RSA-PPP/ppp-2026-13-geotech-multiplexor-24ch/docs/hardware/kicad/acople_esp32/acople_sp32.kicad_sch

## KiCad design docs/hardware/kicad/acople_esp32/acople_sp32.kicad_sch (2026-11-13)

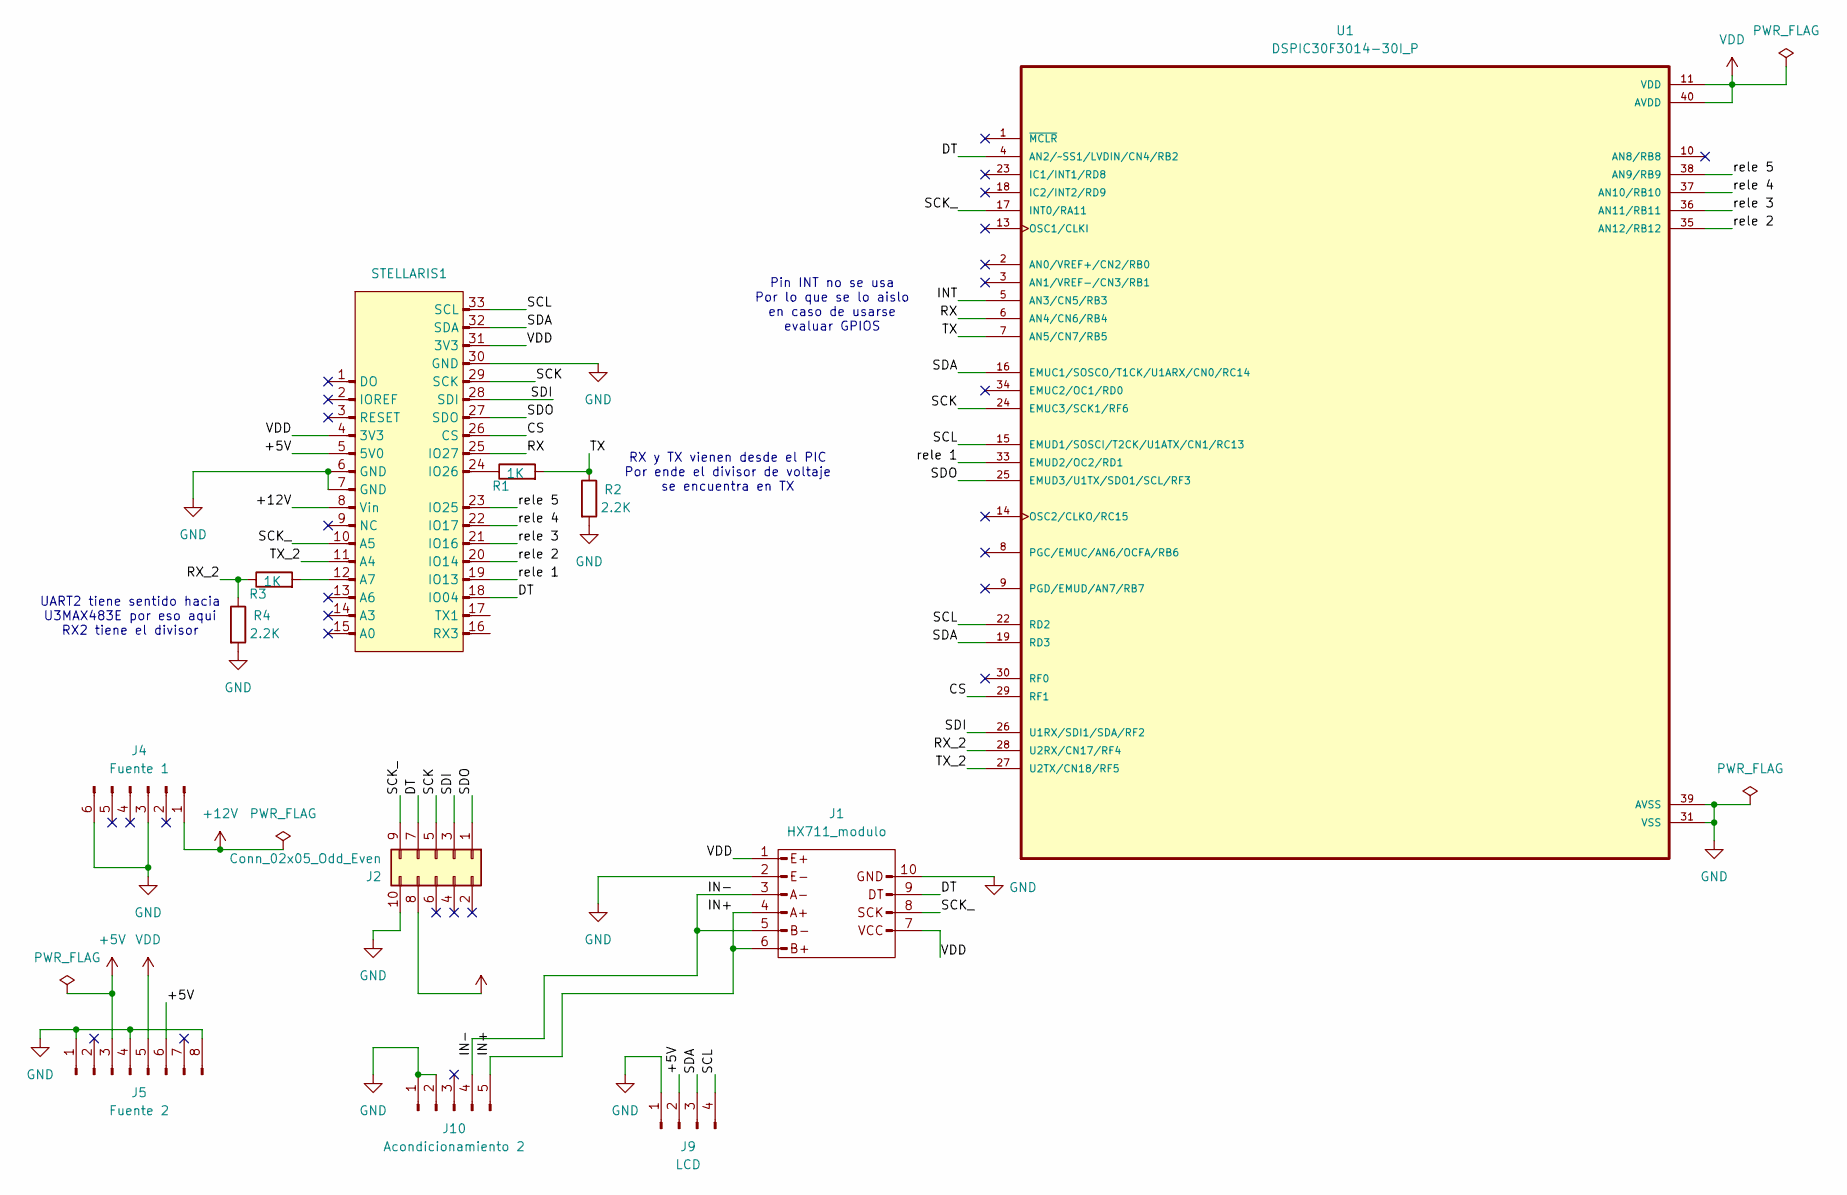
[picture p1: schematic acople_sp32.kicad_sch]

Parts:
J1: HX711_modulo; HX711
J2: Conn_02x05_Odd_Even; PinHeader_2x05_P2.54mm_Vertical
J4: Fuente 1; PinHeader_1x06_P2.54mm_Vertical
J5: Fuente 2; PinHeader_1x08_P2.54mm_Vertical
J9: LCD
J10: Acondicionamiento 2; PinHeader_1x05_P2.54mm_Vertical
R1, R3: 1K; DIP-8_W7.62mm
R2, R4: 2.2K
STELLARIS1: Stellaris_botton
U1: DSPIC30F3014-30I_P; QFP80P1200X1200X120-44N

Connections:
+5V: J5.3, J5.6, J9.2, STELLARIS1.5 (5V0)
+12V: J4.1, STELLARIS1.8 (Vin)
CS: STELLARIS1.26 (CS), U1.29 (RF1)
DT: J1.9, J2.7, STELLARIS1.18 (IO04), U1.4 (AN2/~SS1/LVDIN/CN4/RB2)
GND: J1.2, J1.10, J2.10, J4.3, J4.6, J5.1, J5.4, J5.8, J9.1, J10.1, J10.2, R2.2, R4.2, STELLARIS1.6 (GND), STELLARIS1.7 (GND), STELLARIS1.30 (GND), U1.12 (VSS), U1.20 (VSS), U1.31 (VSS), U1.39 (AVSS)
IN+: J1.4, J1.6, J10.5
IN-: J1.3, J1.5, J10.4
INT: U1.5 (AN3/CN5/RB3)
unnamed: R1.1, STELLARIS1.24 (IO26)
unnamed: R3.2, STELLARIS1.12 (A7)
RX: STELLARIS1.25 (IO27), U1.6 (AN4/CN6/RB4)
RX_2: R3.1, R4.1, U1.28 (U2RX/CN17/RF4)
SCK: J2.5, STELLARIS1.29 (SCK), U1.24 (EMUC3/SCK1/RF6)
SCK_: J1.8, J2.9, STELLARIS1.10 (A5), U1.17 (INT0/RA11)
SCL: J9.4, STELLARIS1.33 (SCL), U1.15 (EMUD1/SOSCI/T2CK/U1ATX/CN1/RC13), U1.22 (RD2)
SDA: J9.3, STELLARIS1.32 (SDA), U1.16 (EMUC1/SOSCO/T1CK/U1ARX/CN0/RC14), U1.19 (RD3)
SDI: J2.3, STELLARIS1.28 (SDI), U1.26 (U1RX/SDI1/SDA/RF2)
SDO: J2.1, STELLARIS1.27 (SDO), U1.25 (EMUD3/U1TX/SDO1/SCL/RF3)
TX: R1.2, R2.1, U1.7 (AN5/CN7/RB5)
TX_2: STELLARIS1.11 (A4), U1.27 (U2TX/CN18/RF5)
VDD: J1.1, J1.7, J2.8, J5.5, STELLARIS1.4 (3V3), STELLARIS1.31 (3V3), U1.11 (VDD), U1.21 (VDD), U1.32 (VDD), U1.40 (AVDD)
rele 1: STELLARIS1.19 (IO13), U1.33 (EMUD2/OC2/RD1)
rele 2: STELLARIS1.20 (IO14), U1.35 (AN12/RB12)
rele 3: STELLARIS1.21 (IO16), U1.36 (AN11/RB11)
rele 4: STELLARIS1.22 (IO17), U1.37 (AN10/RB10)
rele 5: STELLARIS1.23 (IO25), U1.38 (AN9/RB9)

Notes on the sheet:
RX y TX vienen desde el PIC Por ende el divisor de voltaje se encuentra en TX
UART2 tiene sentido hacia U3MAX483E por eso aqui RX2 tiene el divisor
Pin INT no se usa Por lo que se lo aislo en caso de usarse evaluar GPIOS
