RSA-PPP/ppp-2026-13-geotech-multiplexor-24ch/docs/hardware/kicad/puente_reles/puente.kicad_sch

## KiCad design docs/hardware/kicad/puente_reles/puente.kicad_sch (2026-11-13)

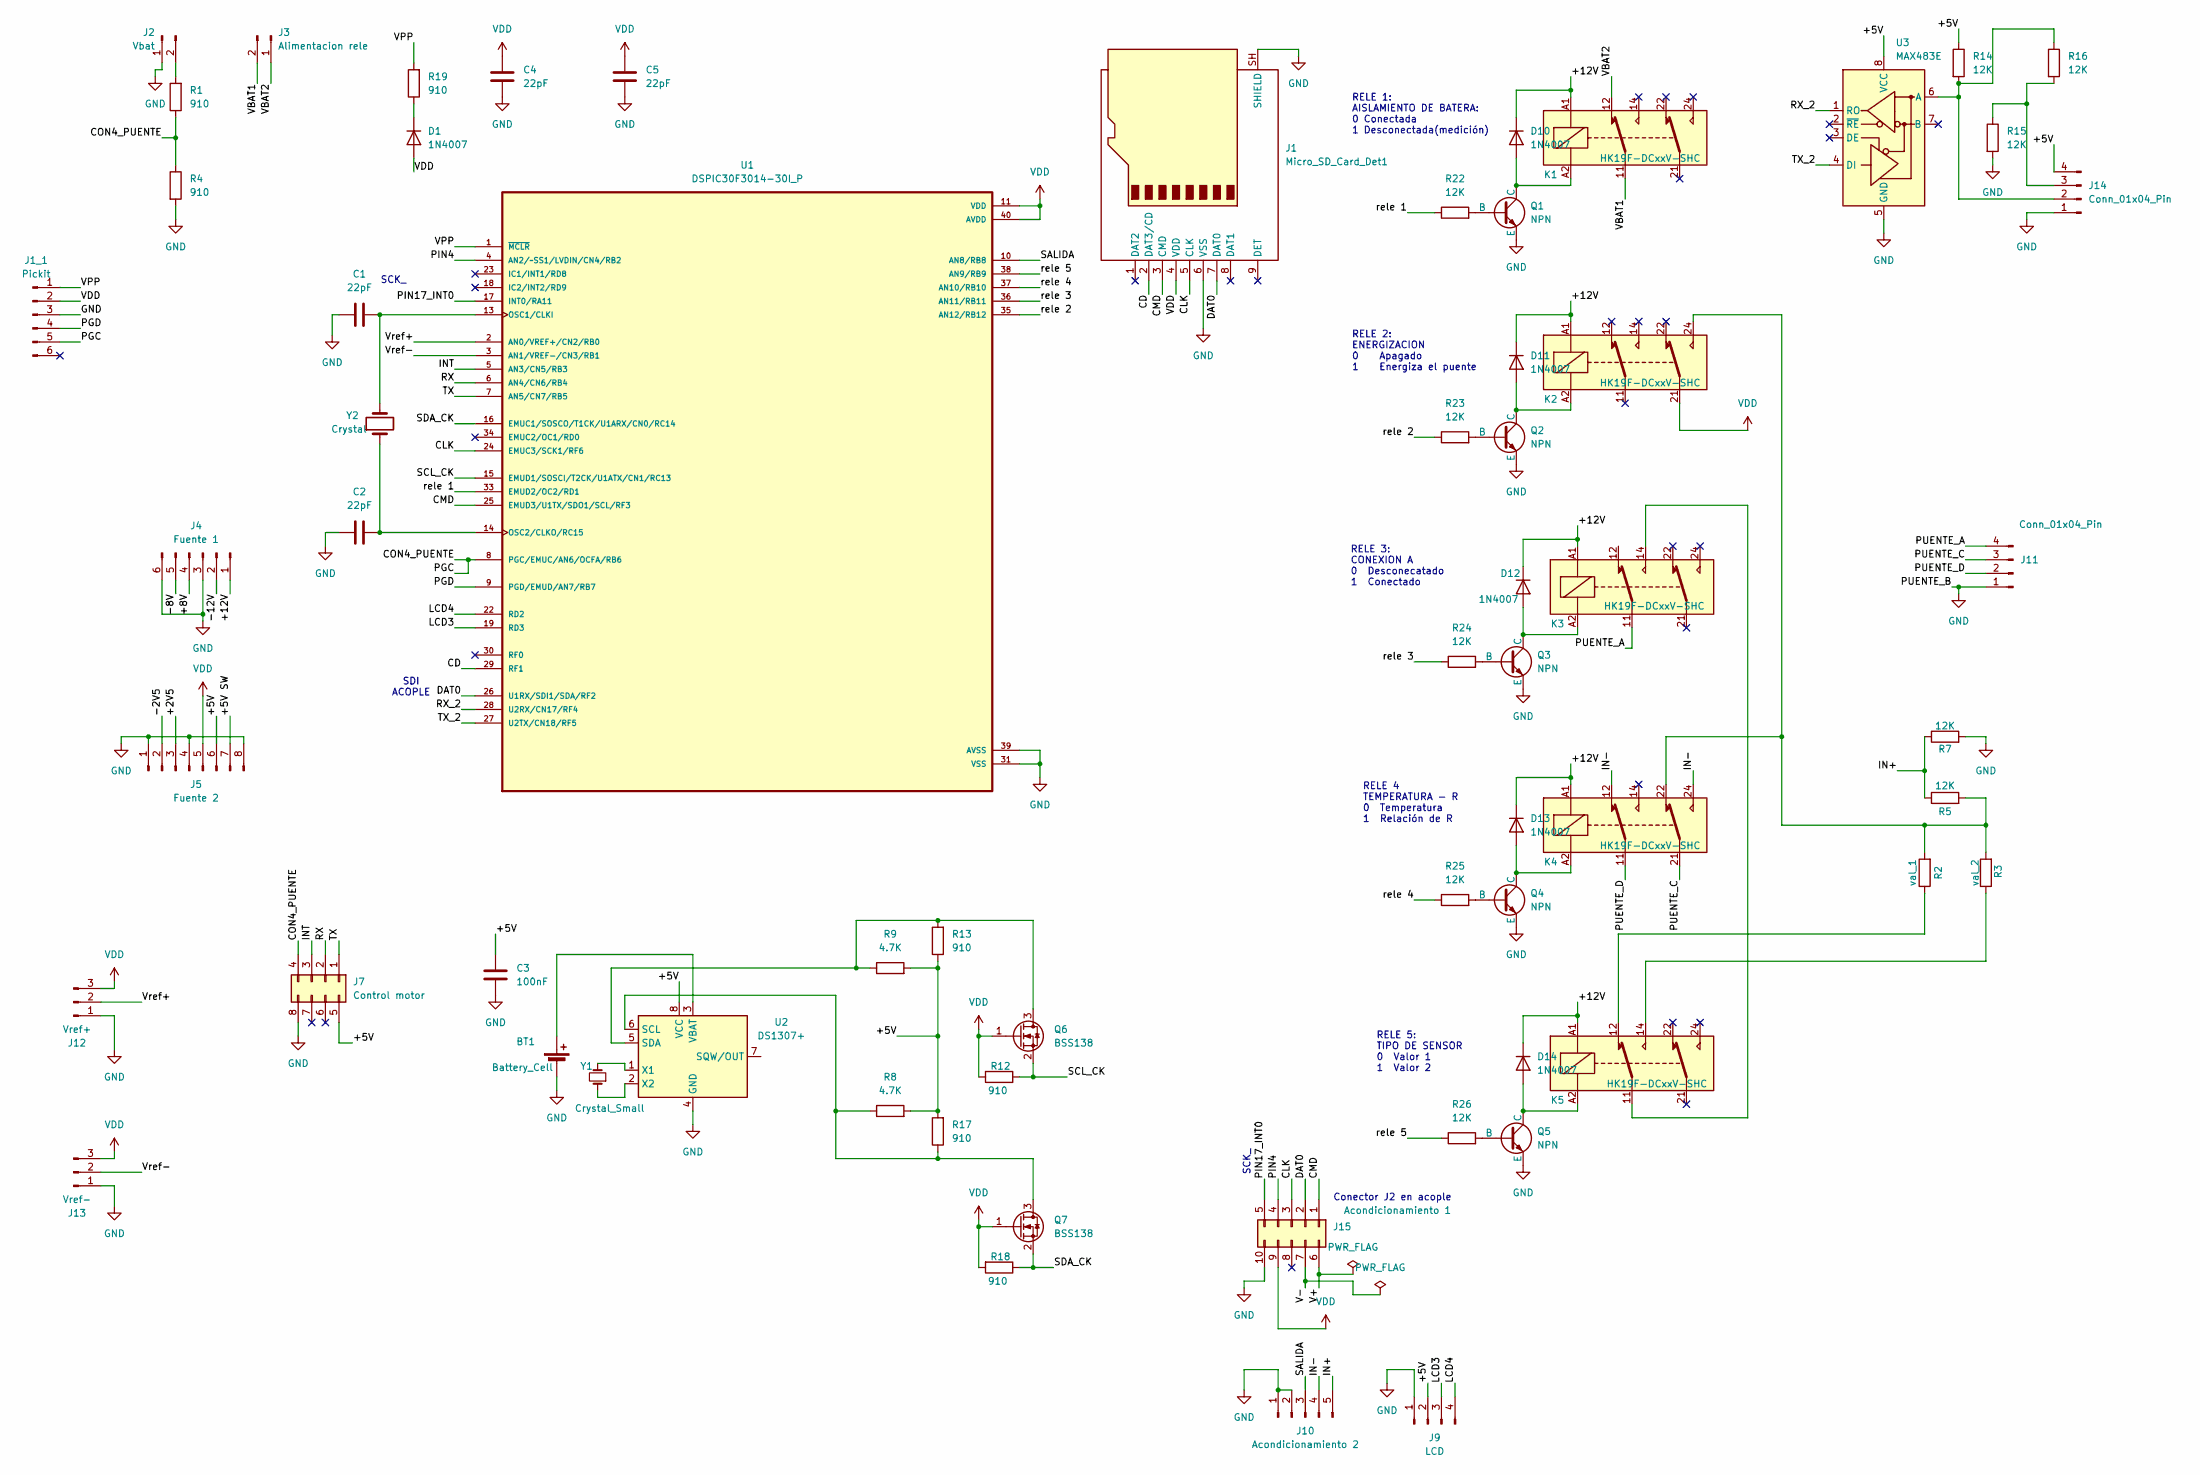
[picture p2: schematic puente.kicad_sch]

Parts:
BT1: Battery_Cell
C1, C2, C4, C5: 22pF
C3: 100nF
D1, D10, D11, D12, D13, D14: 1N4007; D_DO-41_SOD81_P10.16mm_Horizontal
J1: Micro_SD_Card_Det1
J1_1: Pickit
J2: Vbat
J3: Alimentacion rele
J4: Fuente 1
J5: Fuente 2
J7: Control motor
J9: LCD
J10: Acondicionamiento 2
J11, J14: Conn_01x04_Pin
J12: Vref+
J13: Vref-
J15: Acondicionamiento 1
K1, K2, K3, K4, K5: HK19F-DCxxV-SHC; Relay_DPDT_Finder_30.22
Q1, Q2, Q3, Q4, Q5: NPN
Q6, Q7: BSS138; SOT-23
R1, R4, R12, R13, R17, R18, R19: 910
R2: val_1
R3: val_2
R5, R7, R14, R15, R16, R22, R23, R24, R25, R26: 12K
R8, R9: 4.7K
U1: DSPIC30F3014-30I_P; QFP80P1200X1200X120-44N
U2: DS1307+; DIP-8_W7.62mm
U3: MAX483E; SOIC-8_3.9x4.9mm_P1.27mm
Y1: Crystal_Small
Y2: Crystal

Connections:
+2V5: J5.3
+5V: C3.1, J5.6, J7.5, J9.2, J14.4, R8.2, R9.2, R13.1, R14.1, R17.2, U2.8 (VCC), U3.8 (VCC)
+5V SW: J5.7
+8V: J4.4
+12V: D10.1 (K), D11.1 (K), D12.1 (K), D13.1 (K), D14.1 (K), J4.1, K1.A1, K2.A1, K3.A1, K4.A1, K5.A1
-2V5: J5.2
-8V: J4.5
-12V: J4.2
CD: J1.2 (DAT3/CD), U1.29 (RF1)
CLK: J1.5 (CLK), J15.3, U1.24 (EMUC3/SCK1/RF6)
CMD: J1.3 (CMD), J15.1, U1.25 (EMUD3/U1TX/SDO1/SCL/RF3)
CON4_PUENTE: J1_1.5, J7.4, R1.1, R4.1, U1.8 (PGC/EMUC/AN6/OCFA/RB6)
DAT0: J1.7 (DAT0), J15.2, U1.26 (U1RX/SDI1/SDA/RF2)
GND: BT1.2 (-), C1.1, C2.1, C3.2, C4.2, C5.2, J1.6 (VSS), J1.SH (SHIELD), J1_1.3, J2.1, J4.3, J4.6, J5.1, J5.4, J5.8, J7.8, J9.1, J10.1, J10.2, J11.1, J12.1, J13.1, J14.1, J15.10, Q1.3 (E), Q2.3 (E), Q3.3 (E), Q4.3 (E), Q5.3 (E), R4.2, R7.2, R15.2, U1.12 (VSS), U1.20 (VSS), U1.31 (VSS), U1.39 (AVSS), U2.4 (GND), U3.5 (GND)
IN+: J10.5, R5.1, R7.1
IN-: J10.4, K4.12, K4.24
INT: J7.3, U1.5 (AN3/CN5/RB3)
LCD3: J9.3, U1.19 (RD3)
LCD4: J9.4, U1.22 (RD2)
unnamed: BT1.1 (+), U2.3 (VBAT)
unnamed: C1.2, U1.13 (OSC1/CLKI), Y2.2
unnamed: C2.2, U1.14 (OSC2/CLKO/RC15), Y2.1
unnamed: D1.1 (K), R19.1
unnamed: D10.2 (A), K1.A2, Q1.1 (C)
unnamed: D11.2 (A), K2.A2, Q2.1 (C)
unnamed: D12.2 (A), K3.A2, Q3.1 (C)
unnamed: D13.2 (A), K4.A2, Q4.1 (C)
unnamed: D14.2 (A), K5.A2, Q5.1 (C)
unnamed: J2.2, R1.2
unnamed: J14.2, R14.2, R16.1, U3.6 (A)
unnamed: J14.3, R15.1, R16.2
unnamed: K2.24, K4.22, R2.2, R3.2, R5.2
unnamed: K3.14, K5.11
unnamed: K5.12, R2.1
unnamed: K5.14, R3.1
unnamed: Q1.2 (B), R22.2
unnamed: Q2.2 (B), R23.2
unnamed: Q3.2 (B), R24.2
unnamed: Q4.2 (B), R25.2
unnamed: Q5.2 (B), R26.2
unnamed: Q6.3 (D), R9.1, R13.2, U2.5 (SDA)
unnamed: Q7.3 (D), R8.1, R17.1, U2.6 (SCL)
unnamed: U2.1 (X1), Y1.2
unnamed: U2.2 (X2), Y1.1
PGD: J1_1.4, U1.9 (PGD/EMUD/AN7/RB7)
PIN4: J15.4, U1.4 (AN2/~SS1/LVDIN/CN4/RB2)
PIN17_INT0: J15.5, U1.17 (INT0/RA11)
PUENTE_A: J11.4, K3.11
PUENTE_C: J11.3, K4.21
PUENTE_D: J11.2, K4.11
RX: J7.2, U1.6 (AN4/CN6/RB4)
RX_2: U1.28 (U2RX/CN17/RF4), U3.1 (RO)
SALIDA: J10.3, U1.10 (AN8/RB8)
SCL_CK: Q6.2 (S), R12.1, U1.15 (EMUD1/SOSCI/T2CK/U1ATX/CN1/RC13)
SDA_CK: Q7.2 (S), R18.1, U1.16 (EMUC1/SOSCO/T1CK/U1ARX/CN0/RC14)
TX: J7.1, U1.7 (AN5/CN7/RB5)
TX_2: U1.27 (U2TX/CN18/RF5), U3.4 (DI)
V+: J15.6
V-: J15.7
VBAT1: J3.2, K1.11
VBAT2: J3.1, K1.12
VDD: C4.1, C5.1, D1.2 (A), J1.4 (VDD), J1_1.2, J5.5, J12.3, J13.3, J15.9, K2.21, Q6.1 (G), Q7.1 (G), R12.2, R18.2, U1.11 (VDD), U1.21 (VDD), U1.32 (VDD), U1.40 (AVDD)
VPP: J1_1.1, R19.2, U1.1 (~MCLR)
Vref+: J12.2, U1.2 (AN0/VREF+/CN2/RB0)
Vref-: J13.2, U1.3 (AN1/VREF-/CN3/RB1)
rele 1: R22.1, U1.33 (EMUD2/OC2/RD1)
rele 2: R23.1, U1.35 (AN12/RB12)
rele 3: R24.1, U1.36 (AN11/RB11)
rele 4: R25.1, U1.37 (AN10/RB10)
rele 5: R26.1, U1.38 (AN9/RB9)

Notes on the sheet:
SDI ACOPLE
Conector J2 en acople
RELE 3: CONEXION A 0 Desconecatado 1 Conectado
SCK_
RELE 1: AISLAMIENTO DE BATERA: 0 Conectada 1 Desconectada(medición)
RELE 4 TEMPERATURA - R 0 Temperatura 1 Relación de R
RELE 2: ENERGIZACION 0 Apagado 1 Energiza el puente
RELE 5: TIPO DE SENSOR 0 Valor 1 1 Valor 2
