RSA-PPP/ppp-2026-13-geotech-multiplexor-24ch/(commit log)

2026-10-15 feat: homing, conteo de ranuras y frenado dinamico para los dos motores
2026-10-22 feat: agregar protocolo uart del esp32
2026-10-22 feat: agregar firmware esclavo uart del pic
2026-11-05 fix: [corrección de pines uart1 en esp32 y recuperación de atasco mecánico]
    [ControladorPIC.cpp, ControladorPIC.h, main.cpp]
2026-11-05 fix: [ajuste de torque en rampa de desaceleración del pic16f628a para evitar atasco]
    [main_esclavo.c]
2026-11-10 feat: driver hx711 de 24 bits y secuenciador de reles k1..k5 con tiempos muertos
2026-11-13 test: calibracion experimental con caja de decadas patron y cierre de fase 4
2026-11-13 fix: Modificacion y correción de esquematicos , UART1/UART2
    [acople_sp32.kicad_sch, puente.kicad_sch]
2026-11-13 feat: Datalogger MicroSD fat32, Interfaz LCD I2C y Protocolo SCADA-ASCII
